Dolmixx/Cattail/README.md

# Cattail 
Screenshot 2026-06-19 at 4 37 50 PM

Have you ever wanted your very own Cattail? Well now you can! From the nostalgic game Plants Versus Zombies, Cattail is your adorable 3D printed companion equipped with an arduino, sonar sensor, DC motor, and a servo motor to protect your back from whatever danger you might find yourself in. 

cat assembelyyyy

Screenshot 2026-06-10 at 9 40 13 PM

Screenshot 2026-06-10 at 9 40 30 PM

# Why was this made?

Plants Versus Zombies was one of my favourite games growing up, and my favourite plant was the Cattail! (who'd have guessed that?) I would purposely spend more sun for no reason just so I could plant it. Additionally this was a good project to test my terrible CAD skills! Please do excuse if it looks a bit wonky, we can chalk that up to it being unique.

# How to operate

Cattail has a mind of its own! (Not really) It follows a code in which it will activate a DC motor that fires toothpicks when the sonar sensor detects something within X distance. It will stop firing when the threat is no longer there. 

Cattail uses a servo sensor in its tail to move around, acting as a turret. If you want your cat to detect things further, change the X value at the top of the code. 

# Set up

Assembly Instructions can be found [here](https://github.com/Dolmixx/Cattail/blob/main/Production/Assembly%20Instructions.md)

Cattail is easy to set up! 

Load up some toothpicks (or something of 6.5cm length and 2mm diameter) into the feeder and watch as the cattail starts firing when it detects an object within its sight. 

# BOM

| | Item | Required | Unit Price (CAD) | Quantity | Price (CAD) | Note | Source | Link |
|---|---|---|---|---|---|---|---|---|
| | DC Motor | 1 | 0.944 | 5 | 4.72 | *Does not come with pre soldered wires* | Aliexpress | https://www.aliexpress.com/item/1005005649744869.html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 |
| | Servo Motor | 1 | 2.64 | 1 | 2.64 | | Aliexpress | https://www.aliexpress.com/item/1005005929037037.html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 |
| | Sonar Sensor | 1 | 1.06 | 1 | 1.06 | | Aliexpress | https://www.aliexpress.com/item/1005012261674383.html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 |
| | Breadboard | 1 | 0.77 | 1 | 0.77 | | Aliexpress | https://www.aliexpress.com/item/1005008642599597.html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 |
| | Male to Male Wires | 17 | 0.07025 | 40 | 2.81 | | Aliexpress | https://www.aliexpress.com/item/1005008002801706.html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 |
| | Female to Male Wires | 4 | 0.069 | 40 | 2.76 | | Aliexpress | https://www.aliexpress.com/item/1005008002801706.html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 |
| | Battery Pack x4 | 1 | 2.78 | 1 | 2.78 | | Aliexpress | https://www.aliexpress.com/item/1005004197639879.html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 |
| | AA Battery | 4 | 0.4 | 4 | 1.6 | | Aliexpress | https://www.aliexpress.com/item/1005011987720458.html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 |
| | 2mm diameter screws  | 6 | 0.177 | 10 | 1.77 | | Aliexpress | https://www.aliexpress.com/item/1005004112054251.html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 |
| | Arduino UNO | 1 | 3.85 | 1 | 3.85 | | Aliexpress | https://www.aliexpress.com/item/1005009850029192.html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 |
| | 9V battery | 1 | 3.97 | 1 | 3.97 | | Walmart | https://www.walmart.ca/en/ip/Great-Value-9-V-6LR61-Alkaline-Battery-1-Pack-5-year-storage-life/6000196063059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 |
| | Snap cable connector | 1 | 0.305 | 10 | 3.05 | | Aliexpress | https://www.aliexpress.com/item/32874851624.html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 |
| | Rubber Band | 1 | 0.65 | 1 | 0.65 | | Aliexpress | https://www.aliexpress.com/item/1005007580262206.html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 |
| | 3D Printer | 1 | -- | 1 | -- | | Elegoo | https://ca.elegoo.com/products/elegoo-neptune-3-pro-fdm-3d-printer-225x225x280mm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 |
| Total | -- | -- | 17.03525 | -- | 32.43 | | -- | -- |

# Credits 
Electronic Models used:

[Servo Motor](https://www.printables.com/model/360145-micro-servo-3d-model-stp) By: Ludvig Broomé

[Arduino UNO](https://www.printables.com/model/358867-arduino-uno-3d-model-stp/files) By: Ludvig Broomé

[DC Motor](https://www.printables.com/model/1083059-generic-3-6v-dc-motor-model) By: Henry Levesque

[Sonar Sensor](https://www.printables.com/model/1443060-hc-sr04-ultrasonic-sensor-module/files) By: Tom Knox

[Battery](https://grabcad.com/library/9v-battery--1) By: Dave Cancilier

Some useful websites/videos that helped me make this project possible: 
https://howtomechatronics.com/tutorials/arduino/ultrasonic-sensor-hc-sr04/#google_vignette

https://www.youtube.com/watch?v=TOedgF0n4yQ 

This project is in no way associated with EA games or the Plants Vs. Zombies branding. This is a non-commercial and fan made project inspired by Plants Vs. Zombies and was created for personal education purposes.
