Dolmixx/Cattail/BOM/Cattail BOM.csv

 | Item | Required | Unit Price (CAD) | Quantity | Price (CAD) | Note | Source | Link
 | DC Motor | 1 | 0.944 | 5 | 4.72 | *Does not come with pre soldered wires* | Aliexpress | https://www.aliexpress.com/item/1005005649744869.html?curPageLogUid=3cTtTx38AGe4
 | Servo Motor | 1 | 2.64 | 1 | 2.64 |  | Aliexpress | https://www.aliexpress.com/item/1005005929037037.html?curPageLogUid=hmxGweT7Ycne
 | Sonar Sensor | 1 | 1.06 | 1 | 1.06 |  | Aliexpress | https://www.aliexpress.com/item/1005012261674383.html?curPageLogUid=lajurDIYcUhv
 | Breadboard | 1 | 0.77 | 1 | 0.77 |  | Aliexpress | https://www.aliexpress.com/item/1005008642599597.html?curPageLogUid=UvXNJ9WUh2Zv
 | Male to Male Wires | 17 | 0.07025 | 40 | 2.81 |  | Aliexpress | https://www.aliexpress.com/item/1005008002801706.html?curPageLogUid=bpxo4v0AZqwf
 | Female to Male Wires | 4 | 0.069 | 40 | 2.76 |  | Aliexpress | https://www.aliexpress.com/item/1005008002801706.html?curPageLogUid=bpxo4v0AZqwf
 | Battery Pack x4 | 1 | 2.78 | 1 | 2.78 |  | Aliexpress | https://www.aliexpress.com/item/1005004197639879.html?curPageLogUid=ckLS0CoZgpTw
 | AA Battery | 4 | 0.4 | 4 | 1.6 |  | Aliexpress | https://www.aliexpress.com/item/1005011987720458.html?curPageLogUid=UbjYgcGQ235k
 | 2mm diameter screws | 6 | 0.177 | 10 | 1.77 |  | Aliexpress | https://www.aliexpress.com/item/1005004112054251.html?curPageLogUid=tTNwGQJJOu02
 | Arduino UNO | 1 | 3.85 | 1 | 3.85 |  | Aliexpress | https://www.aliexpress.com/item/1005009850029192.html?curPageLogUid=niUQWE9HLo1K
 | 9V battery | 1 | 3.97 | 1 | 3.97 |  | Walmart | https://www.walmart.ca/en/ip/Great-Value-9-V-6LR61-Alkaline-Battery-1-Pack-5-year-storage-life/6000196063059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
 | Snap cable connector | 1 | 0.305 | 10 | 3.05 |  | Aliexpress | https://www.aliexpress.com/item/32874851624.html?curPageLogUid=SwmAeShmx63n
 | Rubber Band | 1 | 0.65 | 1 | 0.65 |  | Aliexpress | https://www.aliexpress.com/item/1005007580262206.html?curPageLogUid=wHDE1Am07n1V
 | 3D Printer | 1 | -- | 1 | -- |  | Elegoo | https://ca.elegoo.com/products/elegoo-neptune-3-pro-fdm-3d-printer-225x225x280mm?variant=47691001331990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
Total | -- | -- | 17.03525 | -- | 32.43 |  | -- | --
