Dolmixx/Cattail/Production/CAD Files/Step Files/Cattail Assembly.step

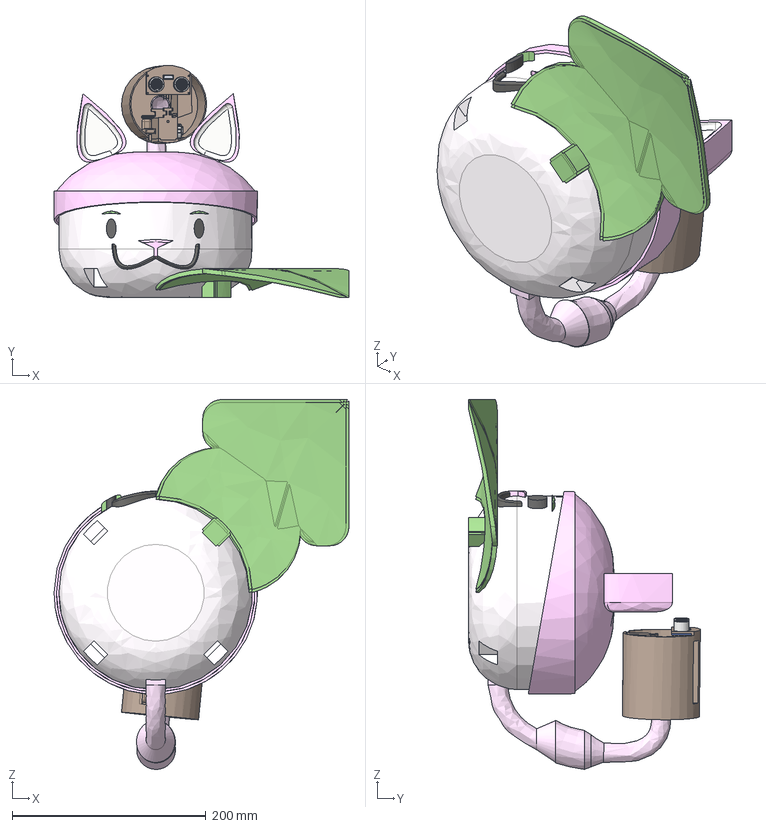
[picture p1: CAD file, 2026-06-21]
Production/CAD Files/Step Files/Cattail Assembly.step
304.5 x 239.3 x 382.0 mm
Document
hc-sr04
SG90-SERVO
ARDUINO-UNO
layer1[1]
18650 Battery Holder 4x
