Dolmixx/Cattail/Production/CAD Files/Step Files/Projectile Mechanism/T Shape Projectile Part.step

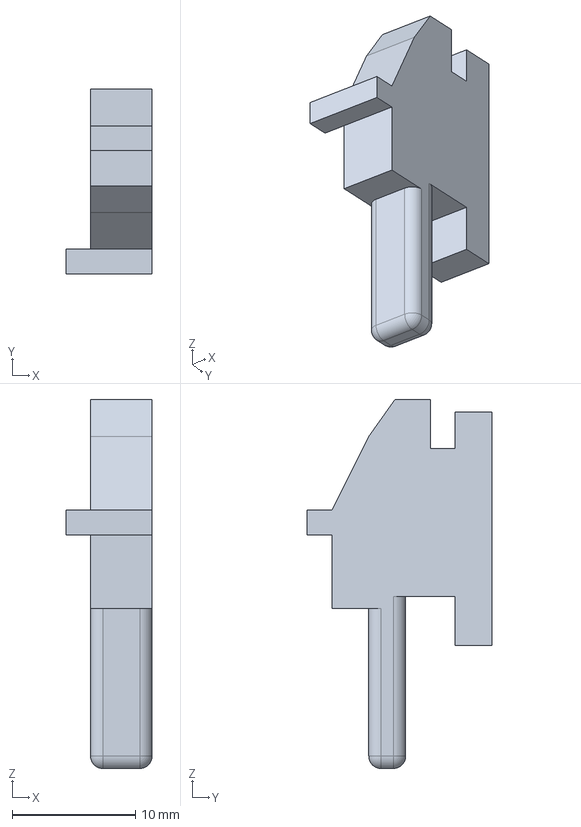
[picture p2: CAD file, 2026-06-09]
Production/CAD Files/Step Files/Projectile Mechanism/T Shape Projectile Part.step
7.00 x 15.0 x 30.0 mm
