Dolmixx/Cattail/Production/CAD Files/Step Files/Cattail Hat.step

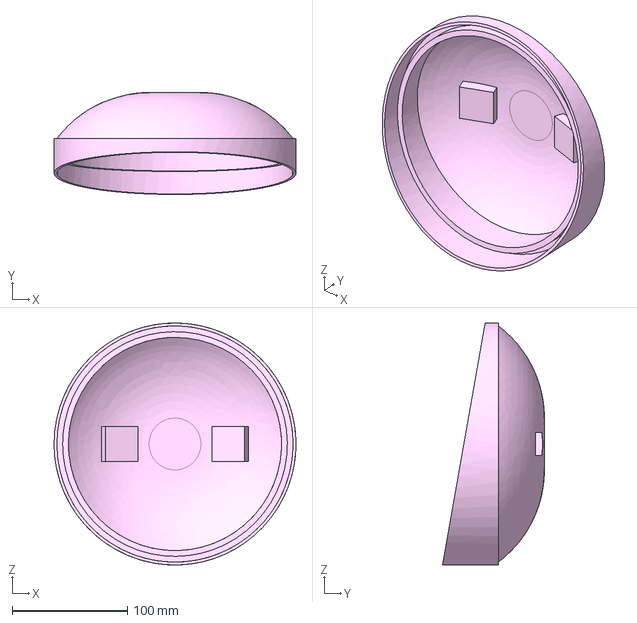
[picture p3: CAD file, 2026-06-18]
Production/CAD Files/Step Files/Cattail Hat.step
210.0 x 88.5 x 210.0 mm
