Dolmixx/Cattail/Production/CAD Files/Step Files/Projectile Mechanism/Joint Projectile Part.step

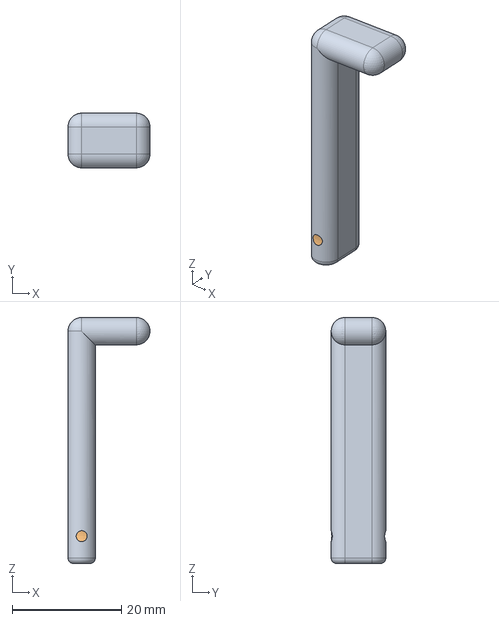
[picture p4: CAD file, 2026-06-09]
Production/CAD Files/Step Files/Projectile Mechanism/Joint Projectile Part.step
15.0 x 10.0 x 45.0 mm
