Dolmixx/Cattail/Production/CAD Files/Step Files/Cattail Corndog.step

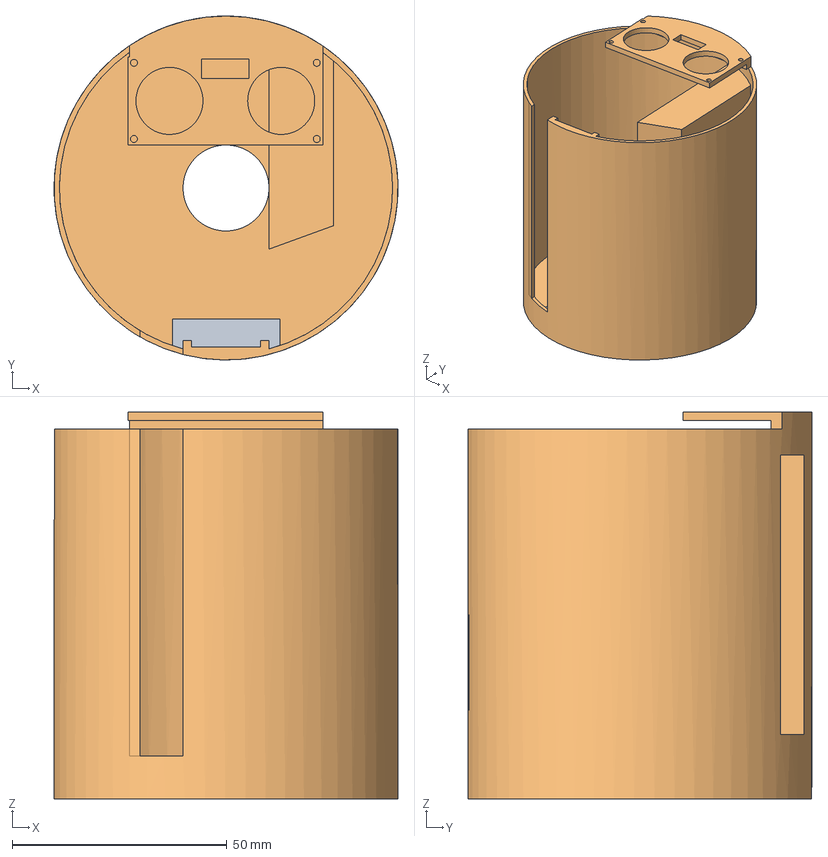
[picture p5: CAD file, 2026-06-10]
Production/CAD Files/Step Files/Cattail Corndog.step
80.0 x 80.0 x 90.0 mm
