Dolmixx/Cattail/Production/CAD Files/Step Files/Projectile Mechanism/Projectile Base.step

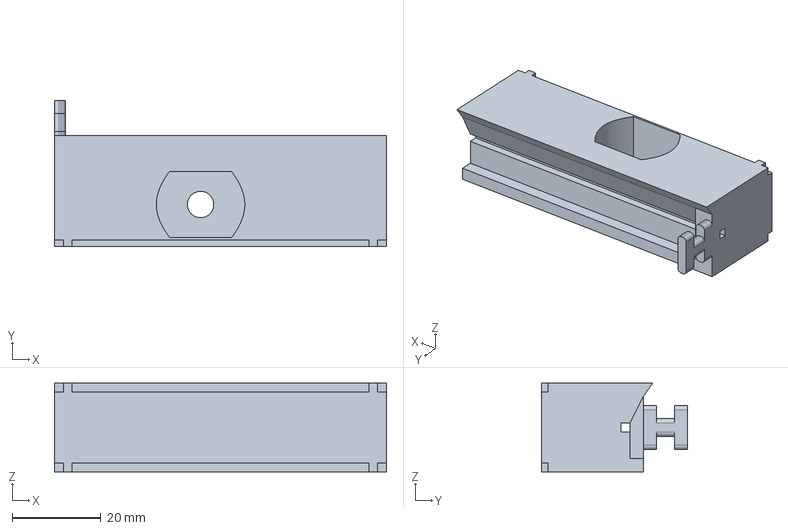
[picture p6: CAD file, 2026-06-09]
Production/CAD Files/Step Files/Projectile Mechanism/Projectile Base.step
75.0 x 33.0 x 20.0 mm
