Dolmixx/Cattail/Production/CAD Files/Step Files/Cattail Middle Tail.step

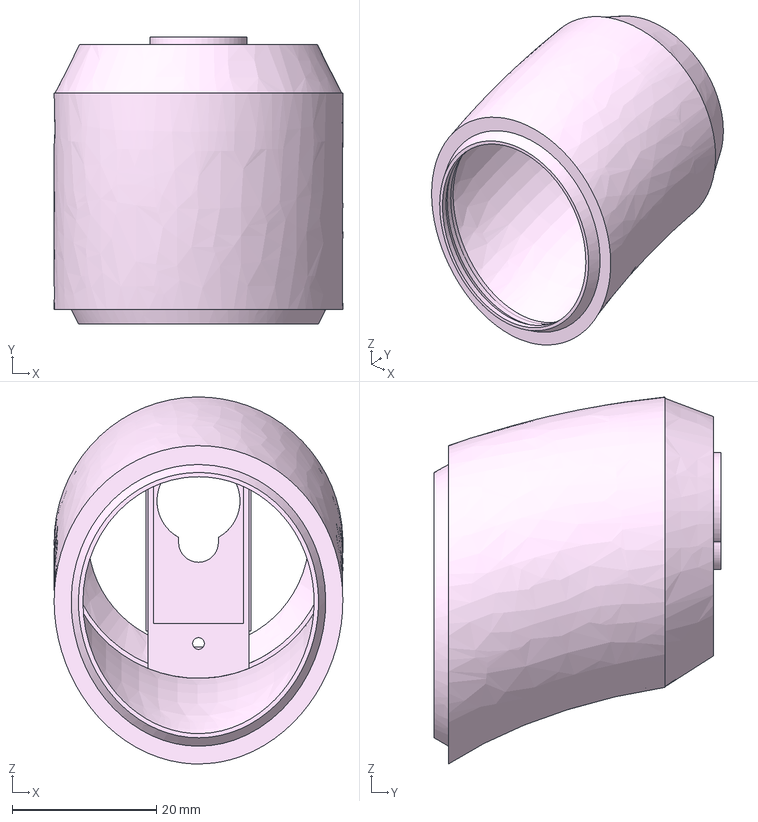
[picture p7: CAD file, 2026-06-10]
Production/CAD Files/Step Files/Cattail Middle Tail.step
40.0 x 39.7 x 50.8 mm
