Dolmixx/Cattail/Production/CAD Files/Step Files/Cattail Upper Tail.step

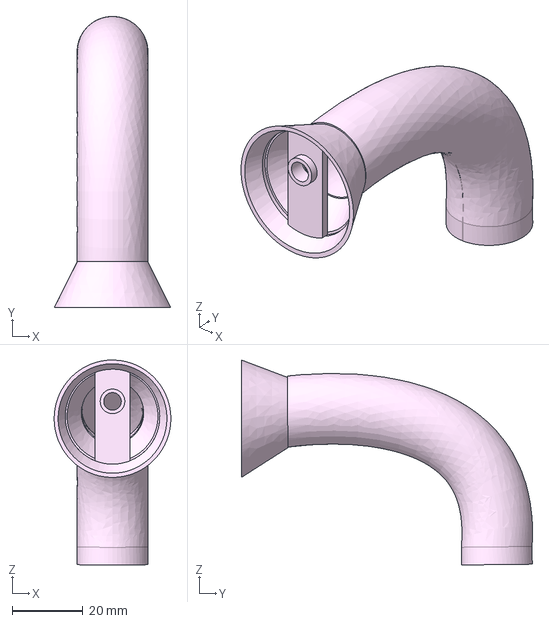
[picture p8: CAD file, 2026-06-10]
Production/CAD Files/Step Files/Cattail Upper Tail.step
32.9 x 82.1 x 57.8 mm
