Dolmixx/Cattail/Production/CAD Files/Step Files/Cattail Leaves.step

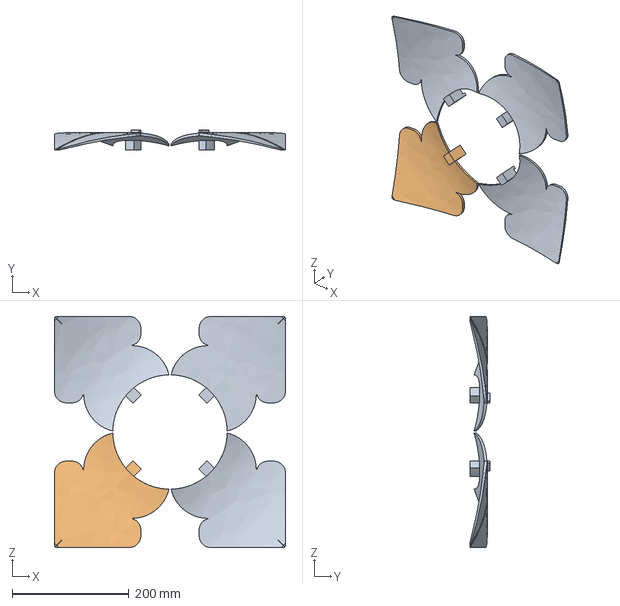
[picture p9: CAD file, 2026-06-09]
Production/CAD Files/Step Files/Cattail Leaves.step
396.0 x 35.0 x 396.0 mm
