Dolmixx/Cattail/Production/CAD Files/Step Files/Cattail Face.step

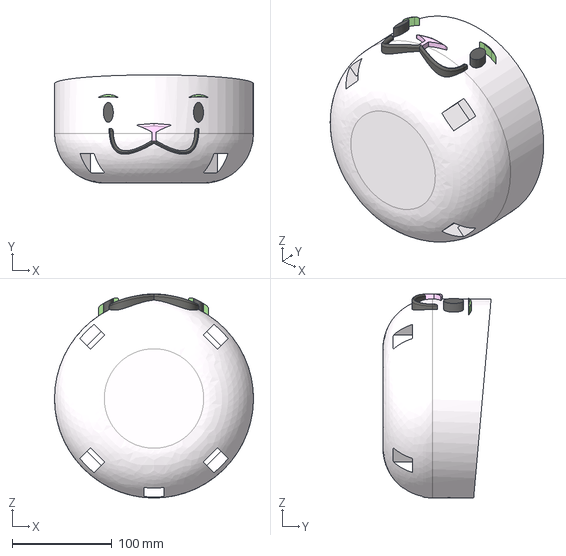
[picture p10: CAD file, 2026-06-09]
Production/CAD Files/Step Files/Cattail Face.step
200.0 x 108.7 x 205.0 mm
