Dolmixx/Cattail/Production/CAD Files/Step Files/Cattail Lower Tail.step

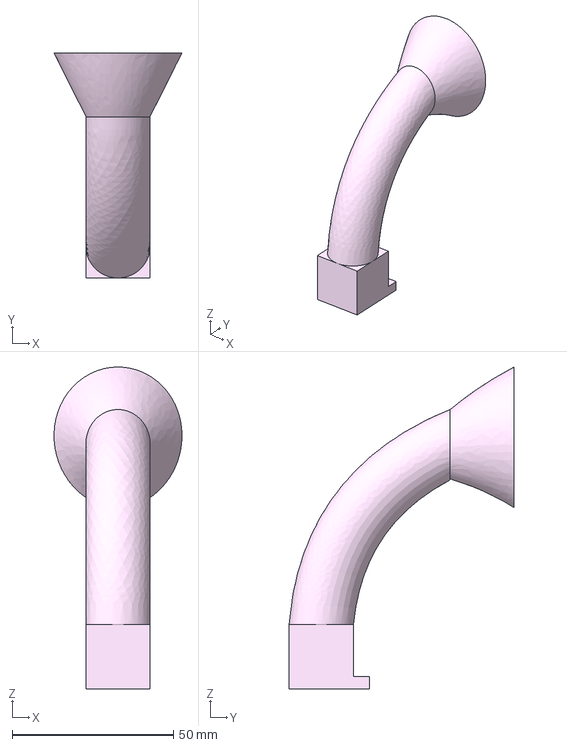
[picture p11: CAD file, 2026-06-09]
Production/CAD Files/Step Files/Cattail Lower Tail.step
39.7 x 69.8 x 99.9 mm
