Dolmixx/Cattail/Production/CAD Files/Step Files/Toothpick.step

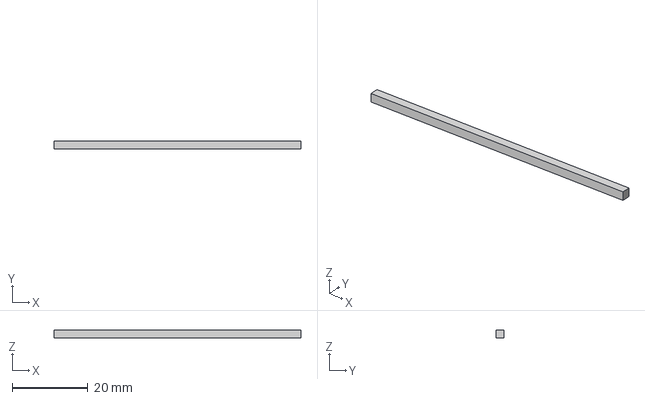
[picture p12: CAD file, 2026-06-09]
Production/CAD Files/Step Files/Toothpick.step
65.0 x 2.00 x 2.00 mm
