Dolmixx/Cattail/Production/CAD Files/Step Files/Cattail Ears.step

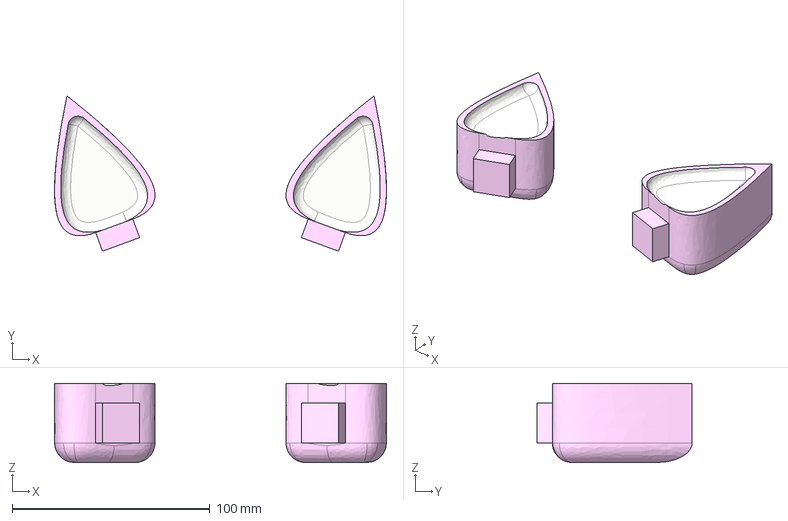
[picture p13: CAD file, 2026-06-09]
Production/CAD Files/Step Files/Cattail Ears.step
168.0 x 78.6 x 40.0 mm
