Dolmixx/Cattail/(list of files, cad)

Other CAD files:
Production/CAD Files/F3D Files/Cattail Assembly.f3z
Production/CAD Files/F3D Files/Cattail Corndog.f3d
Production/CAD Files/F3D Files/Cattail Ears.f3d
Production/CAD Files/F3D Files/Cattail Hat.f3d
Production/CAD Files/F3D Files/Cattail Leaves.f3d
Production/CAD Files/F3D Files/Cattail Lower Tail.f3d
Production/CAD Files/F3D Files/Cattail Middle Tail.f3d
Production/CAD Files/F3D Files/Cattail Upper Tail.f3d
Production/CAD Files/F3D Files/Cattail face.f3d
Production/CAD Files/F3D Files/Projectile Mechanism/Joint Projectile.f3d
Production/CAD Files/F3D Files/Projectile Mechanism/Projectile Base.f3d
Production/CAD Files/F3D Files/Projectile Mechanism/T Shape Projectile.f3d
Production/CAD Files/F3D Files/Projectile Mechanism/Toothpick.f3d
