Dolmixx/Cattail/Cattail Zine.pdf

# CATTAIL

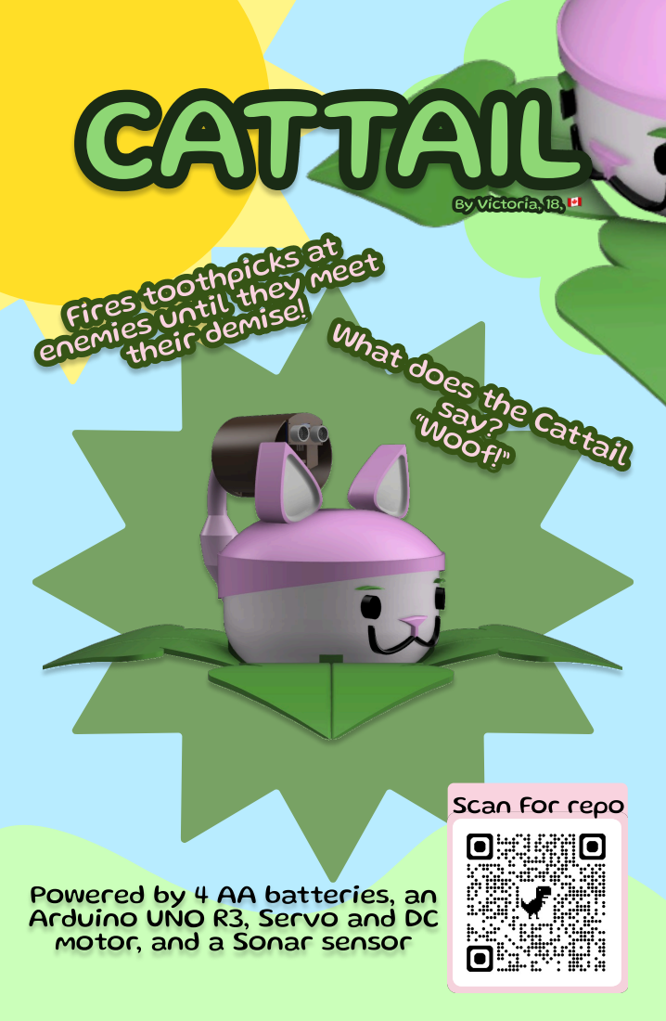
[picture p14: page 1]
By Victoria, 18 🇨🇦; By Victoria, 18, 🇨🇦; “Woof!”

Fires toothpicks at enemies until they meet their demise! What does the Cattail say?

Scan For repo

Powered by 4 AA batteries, an Arduino UNO R3, Servo and DC motor, and a Sonar sensor
