Dolmixx/Cattail/Production/Schematic + Diagram/Cattail Schematic.pdf

A

1 | 2 | 3 | 4 | 5 | 6

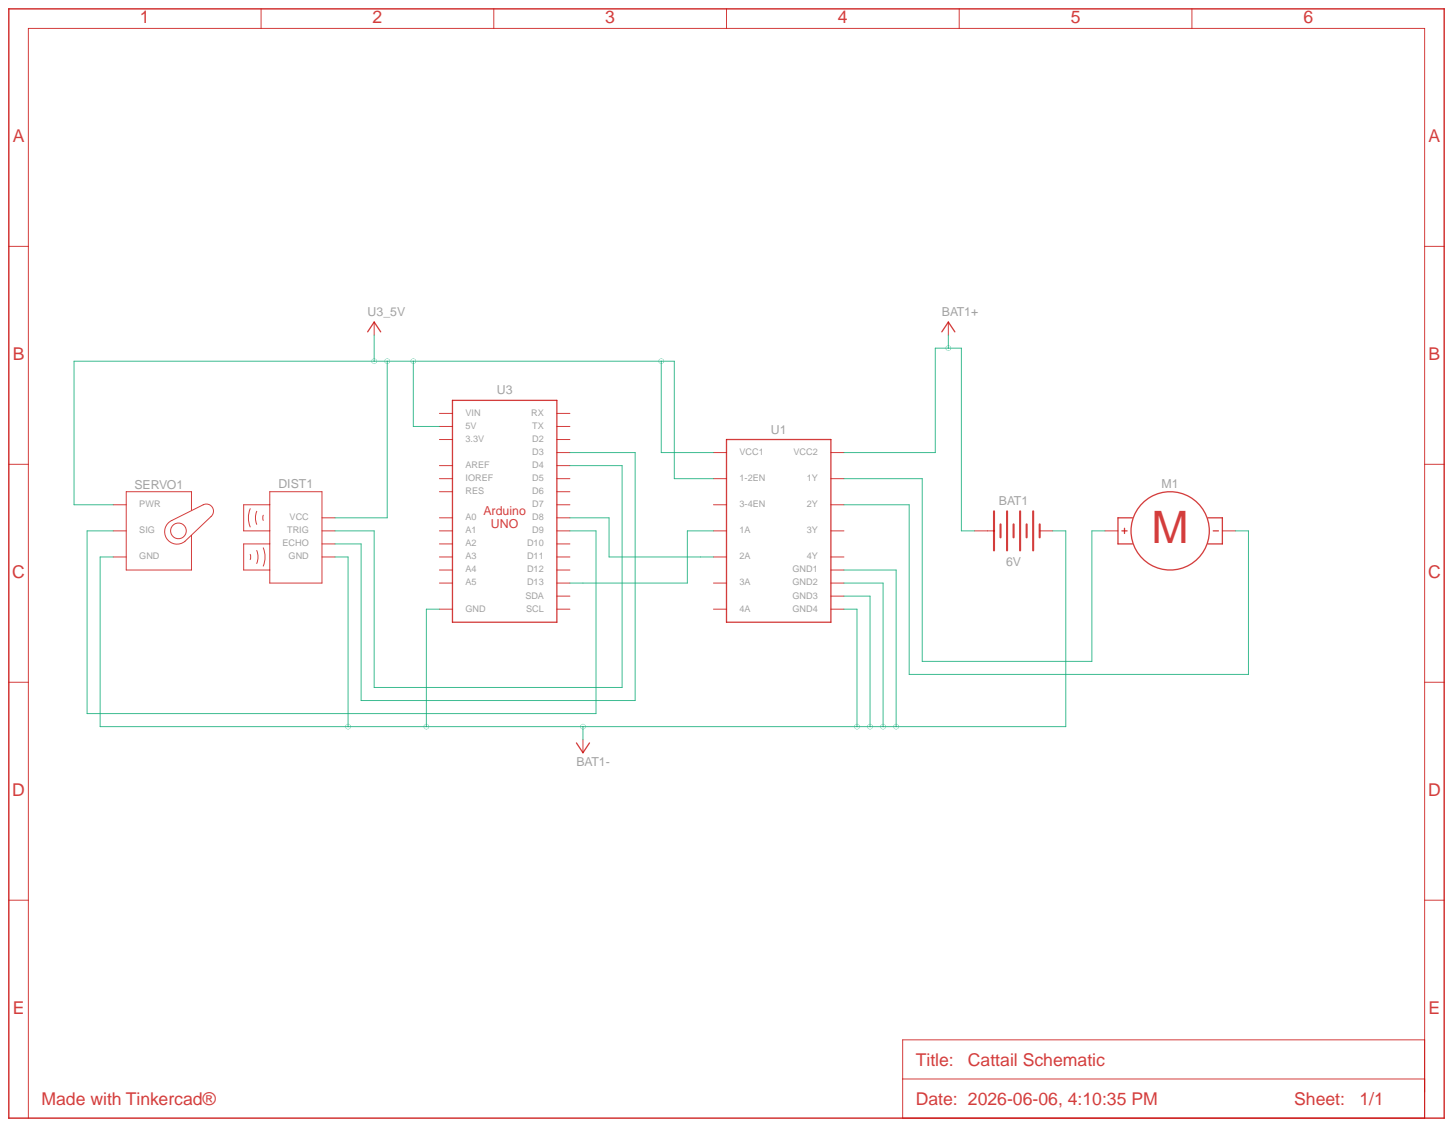
[picture p15: page 1]
