Dolmixx/Cattail/Production/Assembly Instructions.md

# Assembly Instructions 

1. The base 

The cattail has a “base” which is its face as pictured below:

Cattail Face

There should be 4 printed out leaves that can be easily inserted at an angle into the slots on the bottom. 

cattail leaves

They have a section at the end that “hooks” onto an internal flap so that the leaves cannot be pulled out easily. Each leaf can be put into whichever leaf holder, make sure that the leaves are facing the right direction. To check this, make sure the leaf is curved downwards instead of upwards. To remove the leaves, perform the same action but in reverse. 

cattail w leaves

The leaves have no functional purpose other than aesthetics and can be disregarded if you so choose. 

2. The head

The head of the cattail follows a similar design. There is a hat and two ears. The hat should sit on top of the face, making sure to align the slope properly. There is a 5 degree angle on the inside where both pieces land, this should make it so the rim of the front of the hat sits above the Cattails eyebrows. 

cattail hat

cattail w hat and stff

The ears are similar to the leaves where you can simply place them into the dedicated slots on top. These serve no functionality other than appearance and can be discarded if your intention is solely to have a working turret. 

cat

3. The tail (Not to be confused with the main cattail portion)

There are three parts to the tail, the lower, middle, and upper portion. They each have a different purpose. 

Start by taking the lower portion of the tail and inserting it into the back of the Cattail face. There will be a slot in between the back leaves that is raised higher, that is meant for the tail. 

cat back

cat back 2

You will have noticed by now it also features a hole that leads straight into the face, that is on purpose for wires to fit through later. (More about that in the electronic assembly instructions)

Before attaching the middle portion of the tail, it is suggested to screw in the servo motor. If you wish not to have electronics and simply wish to have a model of the Cattail feel free to disregard this step. 

servo

As you assemble you may find it convenient to also assemble the electronics simultaneously. That is up to you to decide. 

Ensure that the middle tail lines up with the lower portion. This can be done by making sure it is sloping down towards the Cat face as well as looking to see if the servo circle opening is facing the back versus being closer to the front. 

The upper portion of the tail can be easily attached by lining up the servo motor opening to the opening on the bottom of the upper portion of the tail. 

cat upper tail

4. The shooter mechanism (The brown portion of the tail)
Note: If you do not wish to have electronics and solely want a Cattail statue, disregard this step and simply attach the cylinder portion approximately .5cm into the tail. 

The last step is to assemble the shooting mechanism. There should be 4 pieces total, the first piece shaped like an L will be referred to as the joint. 

joint

The second piece is a small object similar to a T shape with a long arm on one side will be referred to as the T shape. 

t shape

The third piece is an object resembling a box with a hole at its side which will be referred to as the base. 

base

Finally the fourth piece resembling a cylinder will be referred to as the corndog. 

hotdog

Start by placing a DC motor in the base. There is a hole that should fit it, and push it fully in. You will know it is properly secured when the motor rod is sticking out the other side, as well as there is no more space for you to continue pushing. 

motor + base 1
motor + base 2

Next attach the joint (the L piece) to the motor by looking at the side that has a hole in it and putting it through. Make sure it is securely attached by pushing it all the way through. 

l + base + motor

Place the T shape part on top of the base. There should be a 2mm section that the T shape can slide into. The arm of the T shape should be facing the right side, being able to be touched by the joint. 

ever

You will see an identical looking T shape on the front of the base, attached to a small rubber band that connects the T shapes of both. The idea is that the joint will push the T part away and the rubber band will snap it back forward. 

Take the corndog (cylinder piece) and you will notice theres a hole on one end, and on the other end there will be something that looks like two eyes. On the side with the two eyes, attach the sonar sensor. 

sensor hotdog

The sensor should be placed in a position in which it sticks out in front. There are 4 screw holes to fasten it in. 

Next you will notice on the “floor” of the hotdog on the same side as the sensor there is a rail way like structure. Pointing the base (with all completed steps previously) in where the tiny 2mm hole is facing outwards, you can “snap” it into place by lining it up to the track. 

everythin

Then attach the whole thing to the upper tail, inserting it approx. .5 cm. 

Cattail Full

Congratulations you now have your very own Cattail! 

# Electronic Assembly Instructions 
*images will be added when building begins*
The Arduino sits in the "face" of the cattail alongside the battery pack and batteries. Download and run the Cattail code onto the arduino to begin.

Screenshot 2026-06-20 at 8 09 48 PM

1. Servo motor

Wire as shown in the [wiring diagram](https://github.com/Dolmixx/Cattail/blob/71b2e4feb15a2f312b79d93c6bd7dd4ea0bebad7/Wiring%20Diagram.pdf). The tail is hollow, feed the wires through the tail, use additional jumper wires if necessary. The servo motor can be screwed in.

2. DC Motor + Sonar Sensor

Both should be connected as shown in the wiring diagram. Ensure that the dc motor has its own power supply. The sensor can be screwed in, the DC motor fits in the slot in the corndog.

Feed through the wires through the tail on either side of the gap, make sure the servo rotation does not interfere with the connection.
