Dolmixx/Cattail/Production/Schematic + Diagram/Wiring Diagram.pdf

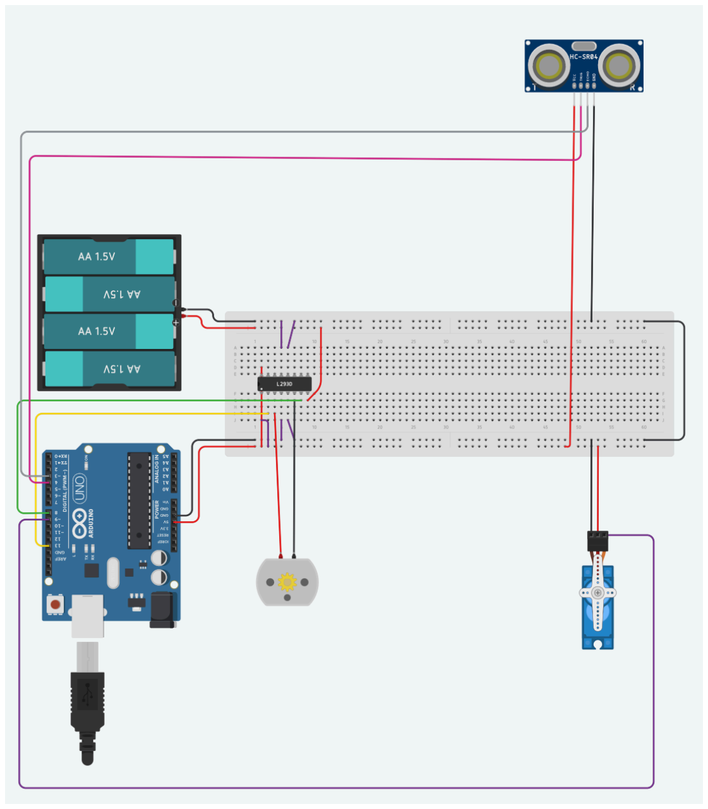
[picture p16: page 1]
