Dolmixx/Cattail/(commit log)

2026-05-20 Concept and wiring
2026-06-09 Cattail Schematic
2026-06-09 Wiring Diagram
2026-06-09 Cad Files
    [Cattail Corndog.step, Cattail Ears.step, Cattail Face.step, Cattail Leaves.step, Cattail Lower Tail.step, Cattail Middle Tail.step, Joint Projectile Part.step, Projectile Base.step]
2026-06-10 Re-upload with updated assembly to include Arduino
    [Cattail Corndog.f3d, Cattail Corndog.step, Cattail Ears.f3d, Cattail Ears.step, Cattail Face.step, Cattail Hat.f3d, Cattail Leaves.f3d, Cattail Leaves.step]
2026-06-10 Wrong files
    [Cattail Corndog.f3d, Cattail Corndog.step, Cattail Ears.f3d, Cattail Ears.step, Cattail Face.step, Cattail Hat.f3d, Cattail Leaves.f3d, Cattail Leaves.step]
2026-06-10 F3D files
    [Cattail Corndog.f3d, Cattail Ears.f3d, Cattail Hat.f3d, Cattail Leaves.f3d, Cattail Lower Tail.f3d, Cattail Middle Tail.f3d, Cattail Upper Tail.f3d, Cattail face.f3d]
2026-06-10 step files
    [Cattail Corndog.step, Cattail Ears.step, Cattail Face.step, Cattail Leaves.step, Cattail Lower Tail.step, Cattail Middle Tail.step, Cattail Upper Tail.step, Joint Projectile Part.step]
2026-06-10 Corrected BOM
    [Cattail Bill of Materials.csv]
2026-06-11 clean up fix
    [Cattail Corndog.f3d, Cattail Ears.f3d, Cattail Hat.f3d, Cattail Leaves.f3d, Cattail Lower Tail.f3d, Cattail Middle Tail.f3d, Cattail Upper Tail.f3d, Cattail face.f3d]
2026-06-11 Update link to assembly instructions in README
2026-06-11 Add wiring diagram and schematic links to README
    Added links to wiring diagram and schematic for the Cattail project.
2026-06-15 added BOM to README
2026-06-15 Update Assembly Instructions.md
2026-06-15 Update BOM
    [Cattail Bill of Materials.csv]
